iDiontep/Tetis/ТГЦЕ ограничитель/ТГЦЕ.468367.004 - Ограничитель_МD_УЛ.pdf

Разраб.
Пров.
Н.конт.
Утв
Информационно-удостоверяющий лист | ТГЦЕ.468367.004MD-УЛ | Лист | Листов
| | | 1

Взам. инв.№ Инв. № дубл. Подп. и дата Инв. № подл. Подп. и дата

Номер п/п | Обозначение документа | Наименование изделия, наименование документа | Версия | Номер последнего изменения
1 | ТГЦЕ.468367.004MD | Ограничитель Электронная модель детали | 1
SHA1 | d22353df74afb84b2e1a520e66584a760b874de2
ТГЦЕ.468367.004 - Ограничитель.STL | 11 июля 2024 г., 09:49:37

Перв. примен.

ТГЦЕ.468367.004

Справ. №
