iDiontep/Tetis/ТГЦЕ ограничитель/ТГЦЕ.468367.004 - Ограничитель_МD_УЛ.xls

Sheet: 1
Перв. примен. | ТГЦЕ.468367.004
 |  |  | Номер п/п | Обозначение документа |  |  | Наименование изделия, наименование документа | Версия | Номер последнего изменения
 |  |  | 1 | ТГЦЕ.468367.004MD |  |  | Ограничитель Электронная модель детали | 1
 |  |  | SHA1 |  | d22353df74afb84b2e1a520e66584a760b874de2
Справ. № |  |  | ТГЦЕ.468367.004 - Ограничитель.STL |  |  |  | 11 июля ‎2024 ‎г., ‏09:49:37
Подп. и дата
Инв. № дубл.
Взам. инв.№
Подп. и дата
 |  |  | Разраб.
 |  |  | Пров.
 |  |  | Н.конт.
Инв. № подл. |  |  | Утв
 |  | Информационно- удостоверяющий лист |  |  |  | ТГЦЕ.468367.004MD-УЛ |  |  |  | Лист | Листов
 |  |  |  |  |  |  |  |  |  |  | 1

Sheet: 2
 | Поз. обозна- чение | Наименование | Кол. | Примечание
Подп. и дата
Инв. № дубл.
Взам. инв.№
Подп. и дата
Инв. № подл.
 |  |  |  |  | Лист

Sheet: ЛРИ
 | Лист регистрации изменений
 | Изм. |  | Номера листов (страниц) |  |  |  |  |  |  | Всего листов (страниц) в докум. | № докум. | Входящий № сопроводи-тельного документа и дата | Под- пись | Дата
 |  |  | изменен- ных |  | заменен- ных |  | новых |  | аннули- рован- ных
Подп. и дата
Инв. № дубл.
Взам. инв.№
Подп. и дата
Инв. № подл.
 |  |  |  |  |  |  |  |  |  |  |  |  |  |  | Лист
 | Изм. | Лист |  | № докум. |  | Подп. |  | Дата
