iDiontep/Tetis/ТГЦЕ ограничитель/ТГЦЕ.468367.004 - Ограничитель.STEP

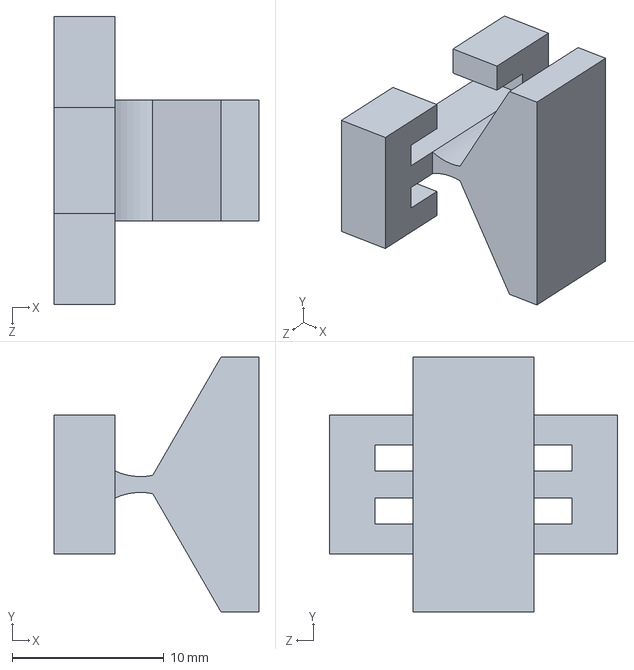
[picture p1: CAD file, 2024-07-11]
ТГЦЕ ограничитель/ТГЦЕ.468367.004 - Ограничитель.STEP
13.5 x 16.8 x 19.0 mm
