iDiontep/Tetis/Чулок/трубка 3.STL

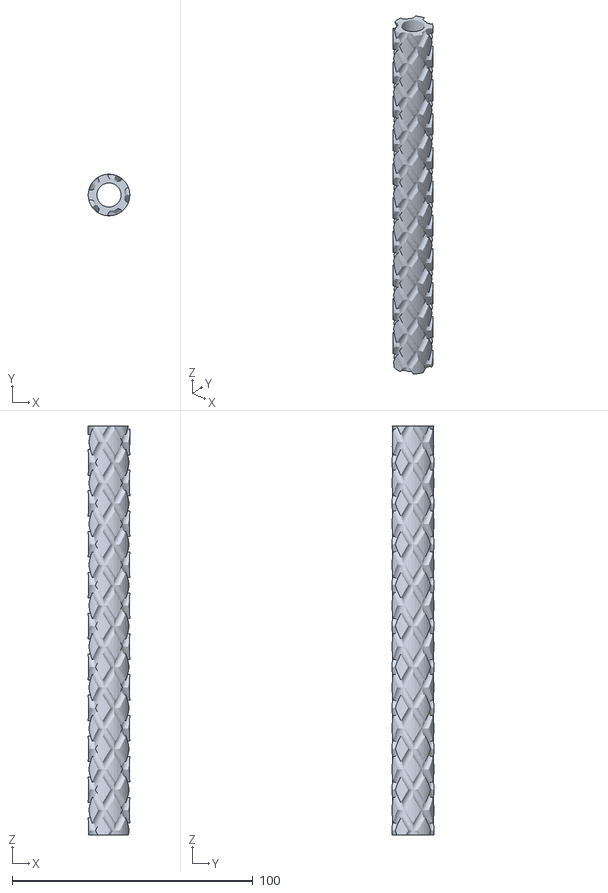
[picture p2: CAD file, 2024-07-11]
Чулок/трубка 3.STL
17.3 x 17.3 x 170.0
