iDiontep/Tetis/Чулок/трубка2.SLDPRT

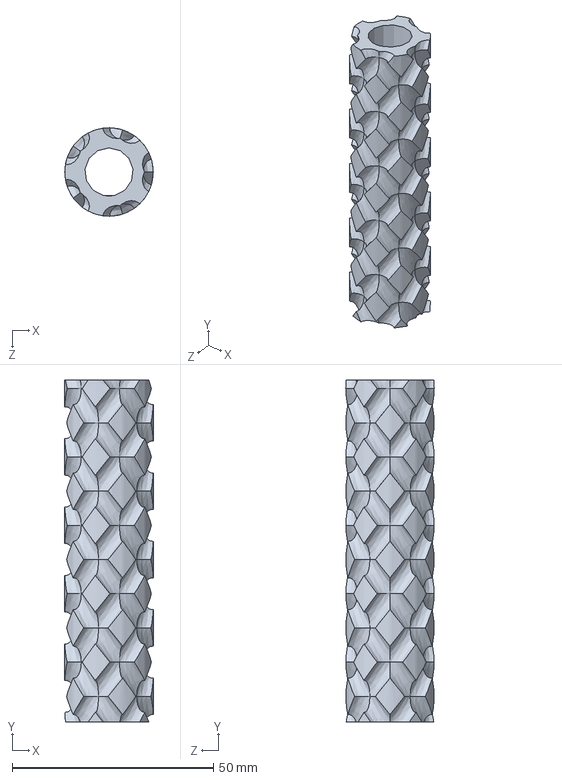
[picture p3: CAD file, 2024-07-11]
Чулок/трубка2.SLDPRT
22.0 x 85.0 x 22.0 mm
