iDiontep/Tetis/(list of files, cad)

Other CAD files:
ТГЦЕ ограничитель/ТГЦЕ.468367.004 - Ограничитель.SLDDRW
ТГЦЕ ограничитель/ТГЦЕ.468367.004 - Ограничитель.SLDPRT
ТГЦЕ ограничитель/ТГЦЕ.468367.004 - Ограничитель.STL
Чулок/трубка2.STL
