iDiontep/Tetis/ТГЦЕ ограничитель/ТГЦЕ.468367.004 - Ограничитель.PDF

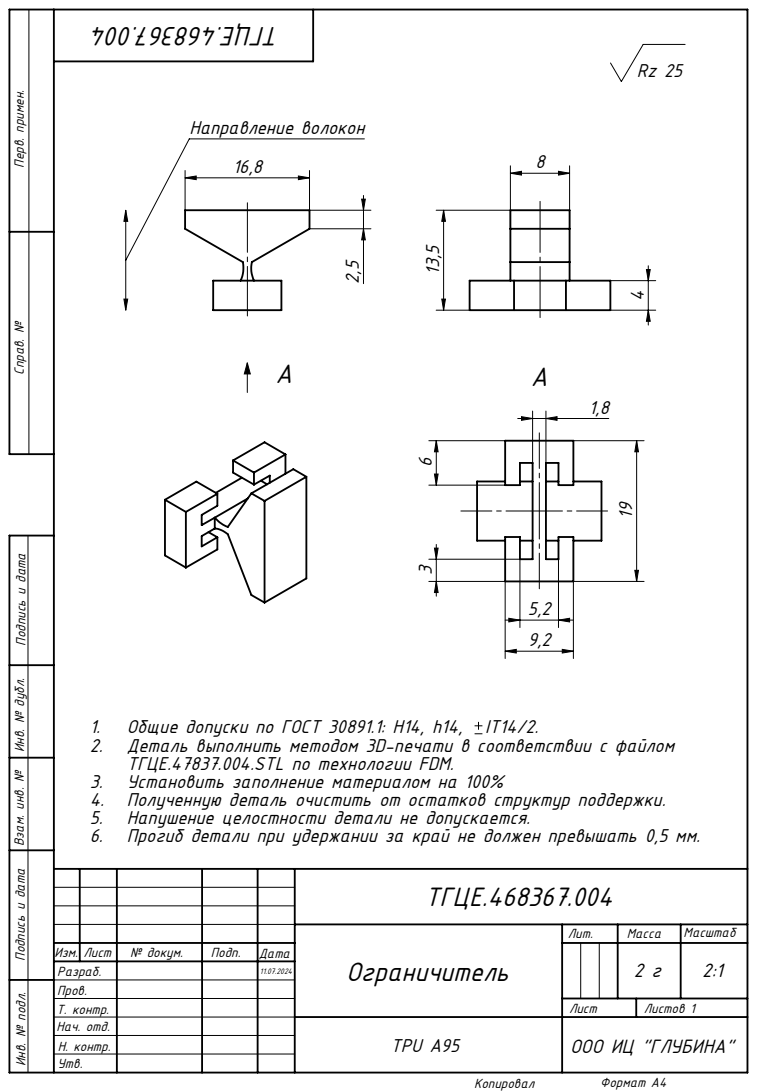
[picture p4: page 1]
Направление волокон; 1. Общие допуски по ГОСТ 30891.1: H14, h14,; Копировал; Формат А4

Подпись и дата Инв. № дубл. Взам. инв. № Подпись и дата Инв. № подл. Справ. № Перв. примен.

2. Деталь выполнить методом 3D-печати в соответствии с файлом
ТГЦЕ.47837.004.STL по технологии FDM.
3. Установить заполнение материалом на 100%
4. Полученную деталь очистить от остатков структур поддержки.
5. Напушение целостности детали не допускается.
6. Прогиб детали при удержании за край не должен превышать 0,5 мм.

ТГЦЕ.468367.004

Ограничитель | Лит. | Масса | Масштаб

Изм. Лист | № докум. | Подп. | Дата | | | | | 2 г | 2:1
Разраб. | | | 11.07.2024
Пров.
Т. контр. | | | | Лист | Листов 1
Нач. отд. | | | TPU A95 | ООО ИЦ "ГЛУБИНА"
Н. контр.
Утв.
