iDiontep/Tetis/(commit log)

2024-07-11 work_1week (ТГЦЕ+чулок)
    [ТГЦЕ.468367.004 - Ограничитель.SLDDRW, ТГЦЕ.468367.004 - Ограничитель.SLDPRT, ТГЦЕ.468367.004 - Ограничитель.STEP, трубка 3.STL, трубка2.SLDPRT, трубка2.STL]
2024-07-11 revision of MD files
    [ТГЦЕ.468367.004 - Ограничитель.SLDDRW, ТГЦЕ.468367.004 - Ограничитель.SLDPRT, ТГЦЕ.468367.004 - Ограничитель.STL, ТГЦЕ.468367.004 - Ограничитель_МD_УЛ.xls]
2024-07-11 MD included in main draw
    [ТГЦЕ.468367.004 - Ограничитель.SLDDRW]
2024-07-11 ТГЦЕ updated material
    [ТГЦЕ.468367.004 - Ограничитель.SLDDRW, ТГЦЕ.468367.004 - Ограничитель.SLDPRT]
